opsobot/rebelia/hardware/renders/Rebelia - Open Source Robotic Hand - front.png

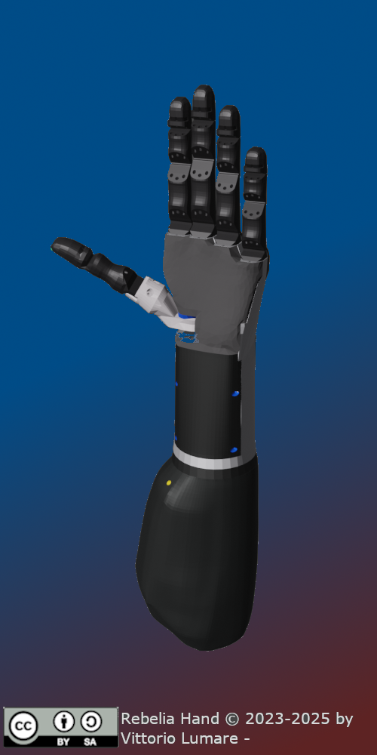
hardware/renders/Rebelia - Open Source Robotic Hand - front.png
