opsobot/rebelia/hardware/Electronics/Prosthetic Version/PdfFiles_ServoBoard Slim/MASK1.pdf

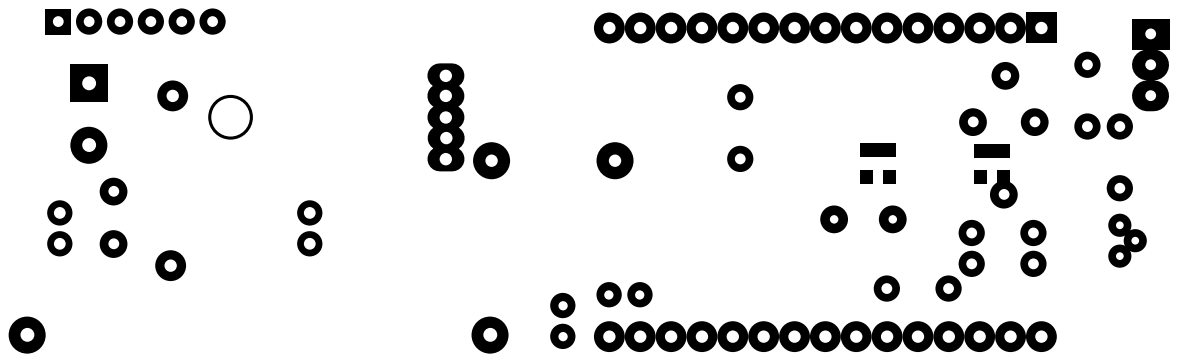
[picture p2: page 1]
