opsobot/rebelia/hardware/Electronics/Prosthetic Version/ServoBoard Slim.png

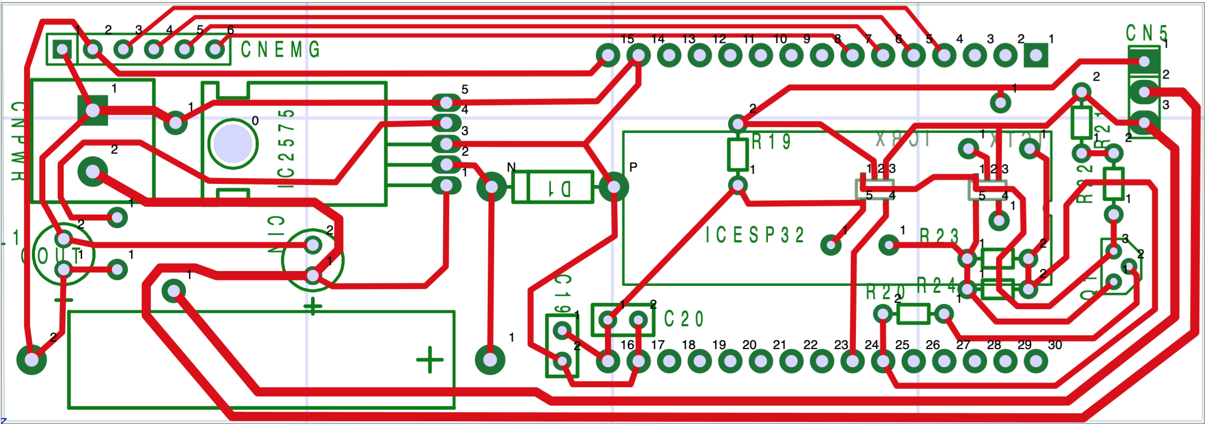
hardware/Electronics/Prosthetic Version/ServoBoard Slim.png
