opsobot/rebelia/hardware/renders/Rebelia - Open Source Robotic Hand - back.png

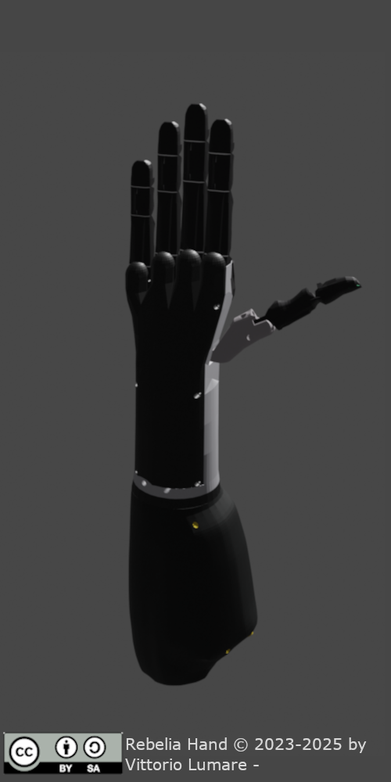
hardware/renders/Rebelia - Open Source Robotic Hand - back.png
