opsobot/rebelia/hardware/renders/Rebelia - Open Source Robotic Hand - left.png

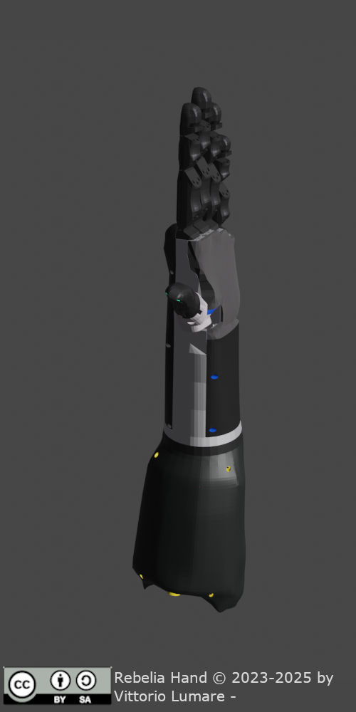
hardware/renders/Rebelia - Open Source Robotic Hand - left.png
