opsobot/rebelia/hardware/renders/Rebelia - Open Source Robotic Hand - right.png

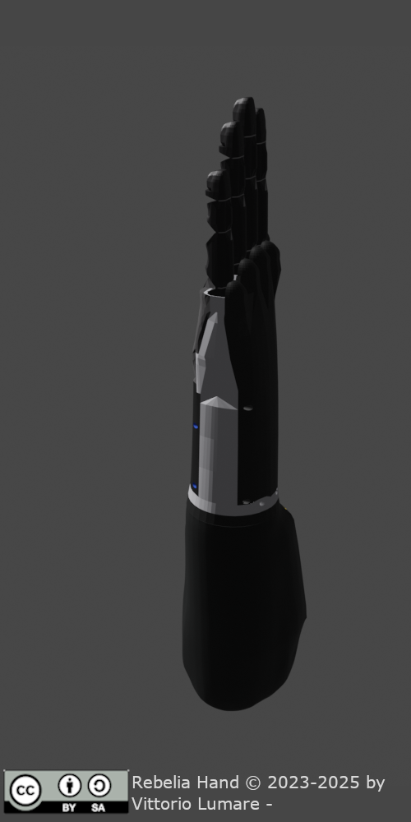
hardware/renders/Rebelia - Open Source Robotic Hand - right.png
