opsobot/rebelia/hardware/Electronics/Prosthetic Version/GerberFiles_ServoBoard Slim/BOM.TXT

1	1	1N4XXX		D1	
2	6	AXIAL0.2		R19	R20	R21	R22	R23	R24	
3	1	AXIAL1.50		L1	
4	1	DIP30-WIDE11		ICESP32	
5	2	DPV		ICRX	ICTX	
6	1	POWER2		CNPWR	
7	2	RAD0.1		C19	C20	
8	2	RB.1.2		CIN	COUT	
9	1	SIP3		CN5	
10	1	SIP6		CNEMG	
11	1	TO-220-5pin		IC2575	
12	1	TO-92A		Q1
