opsobot/rebelia/hardware/CAD/STL/Thumb Flex.stl

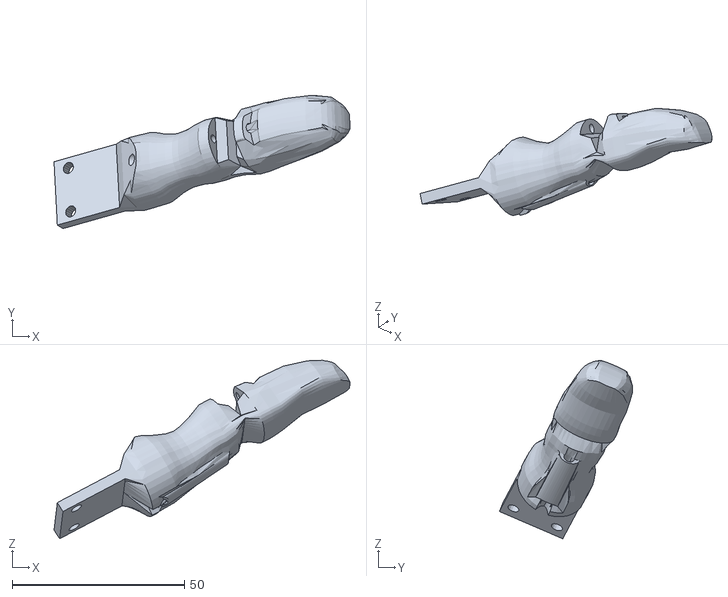
[picture p7: CAD file, 2025-03-03]
hardware/CAD/STL/Thumb Flex.stl
85.8 x 38.6 x 51.8
