opsobot/rebelia/hardware/CAD/STL/Little Flex.stl

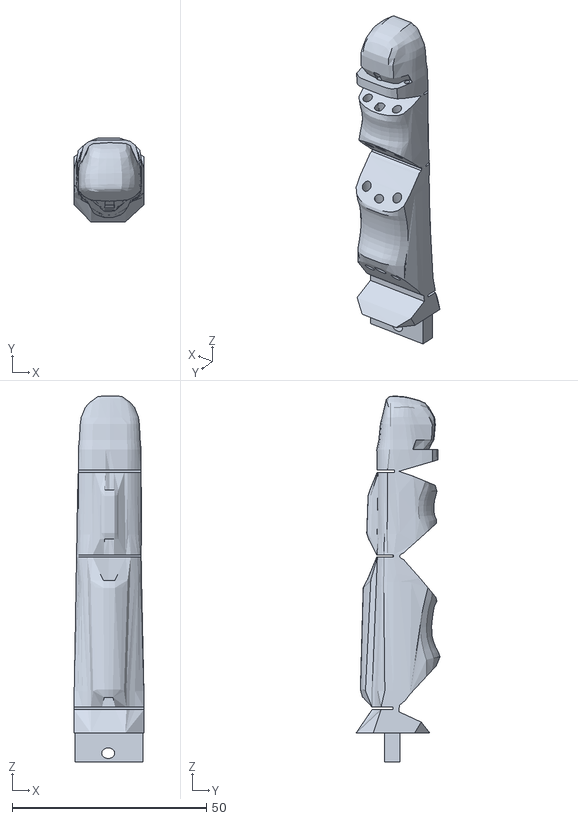
[picture p8: CAD file, 2025-03-03]
hardware/CAD/STL/Little Flex.stl
18.0 x 21.6 x 94.2
