opsobot/rebelia/hardware/CAD/STL/Middle Flex.stl

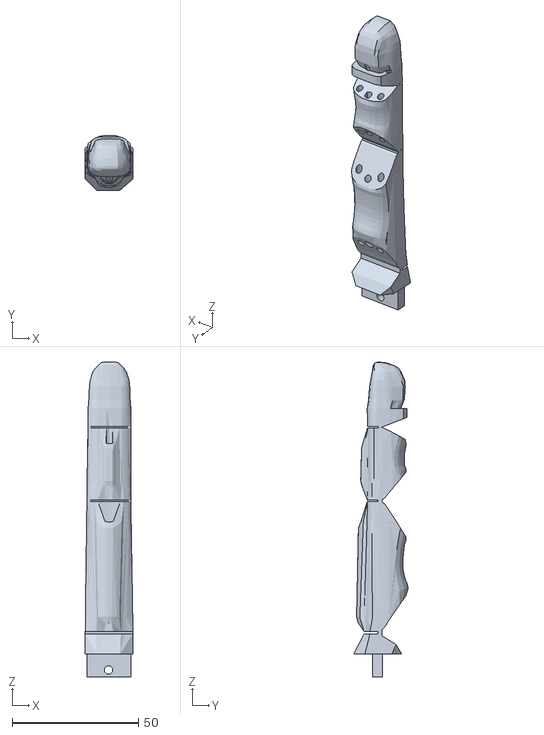
[picture p9: CAD file, 2025-03-03]
hardware/CAD/STL/Middle Flex.stl
18.9 x 21.6 x 124.8
