opsobot/rebelia/hardware/CAD/STL/Prosthetic Socket Cover - Wrist Connection.stl

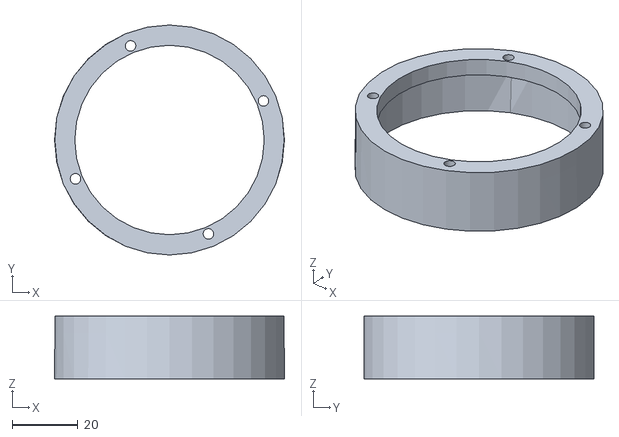
[picture p10: CAD file, 2025-03-03]
hardware/CAD/STL/Prosthetic Socket Cover - Wrist Connection.stl
70.0 x 70.0 x 19.0
