opsobot/rebelia/hardware/CAD/STL/Ring Rigid.stl

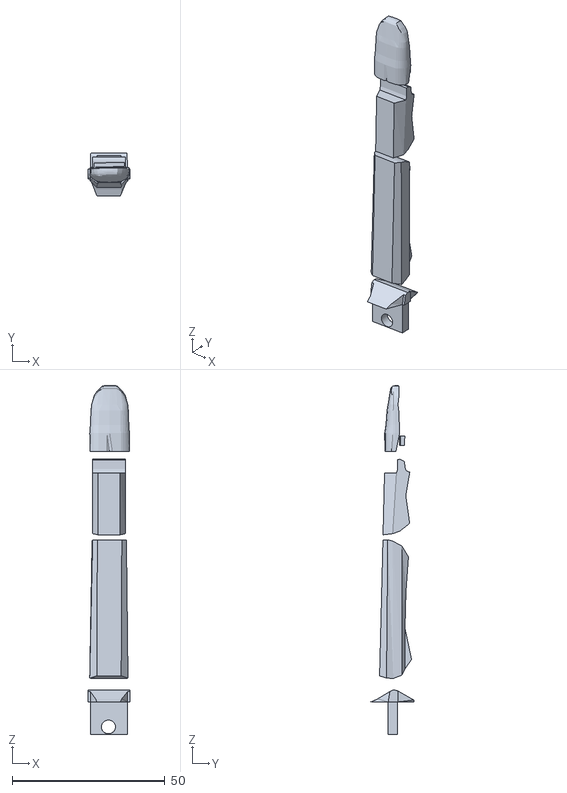
[picture p11: CAD file, 2025-03-03]
hardware/CAD/STL/Ring Rigid.stl
13.8 x 14.1 x 114.3
