opsobot/rebelia/hardware/CAD/STL/Lower Forearm Cover Front.stl

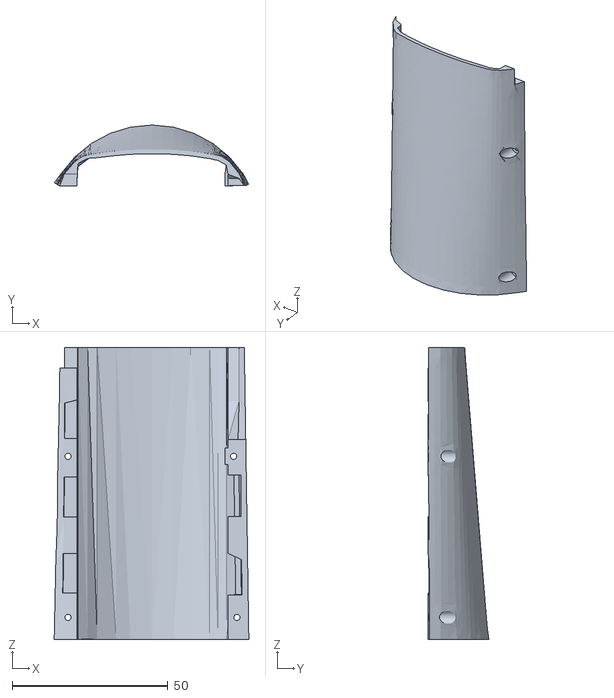
[picture p12: CAD file, 2025-03-03]
hardware/CAD/STL/Lower Forearm Cover Front.stl
62.6 x 19.6 x 93.9
