opsobot/rebelia/hardware/CAD/STL/Wrist Stop Flange.stl

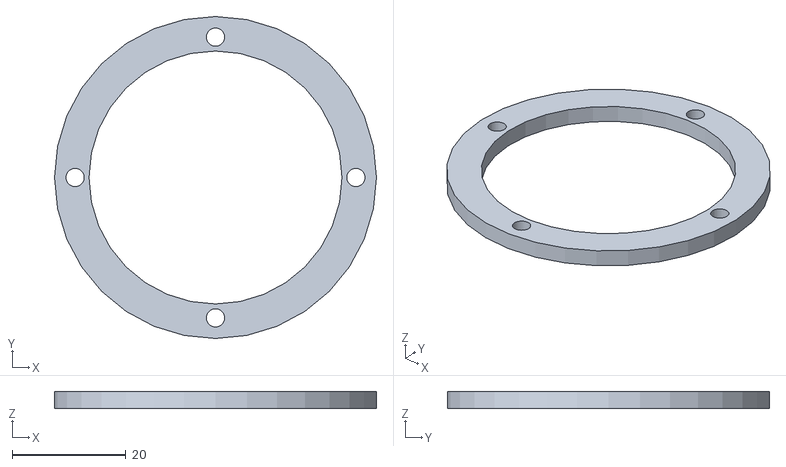
[picture p13: CAD file, 2025-03-03]
hardware/CAD/STL/Wrist Stop Flange.stl
56.5 x 56.5 x 3.00
