opsobot/rebelia/hardware/CAD/STL/Index Rigid.stl

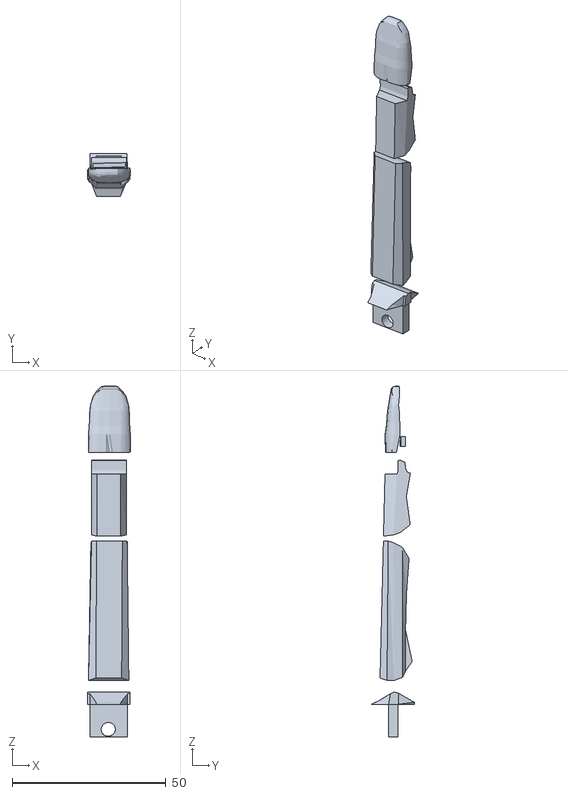
[picture p14: CAD file, 2025-03-03]
hardware/CAD/STL/Index Rigid.stl
13.9 x 14.1 x 114.3
