opsobot/rebelia/hardware/CAD/STL/Skeleton.stl

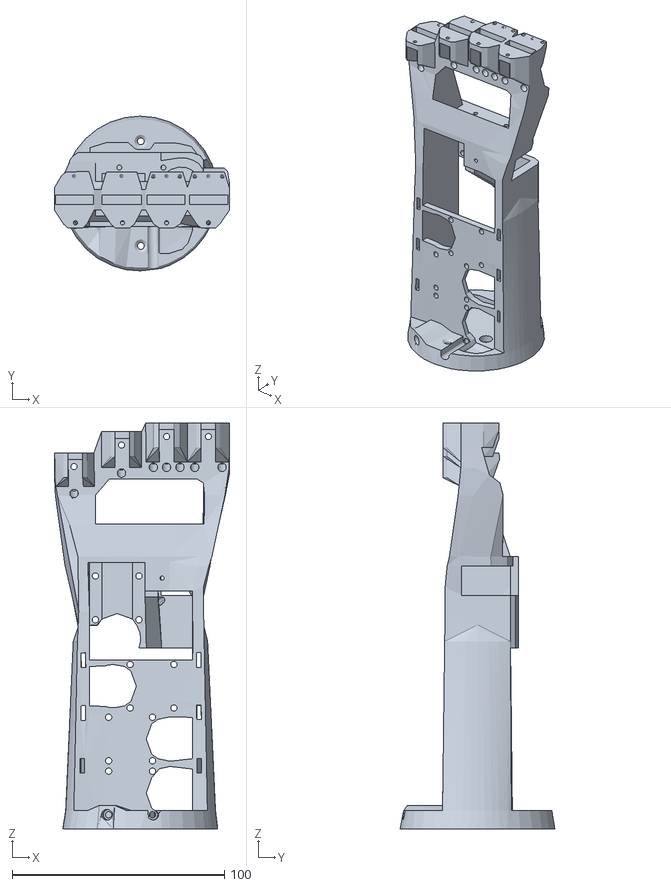
[picture p15: CAD file, 2025-03-03]
hardware/CAD/STL/Skeleton.stl
82.5 x 72.9 x 191.3
