opsobot/rebelia/hardware/CAD/STL/Middle Rigid.stl

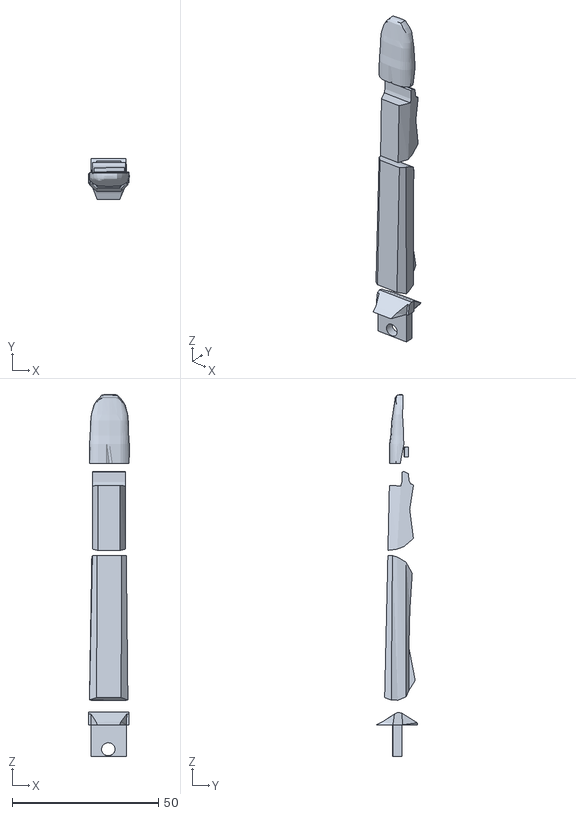
[picture p16: CAD file, 2025-03-03]
hardware/CAD/STL/Middle Rigid.stl
13.9 x 14.1 x 123.9
