opsobot/rebelia/hardware/CAD/STL/Prosthetic Socket Cover - Panel.stl

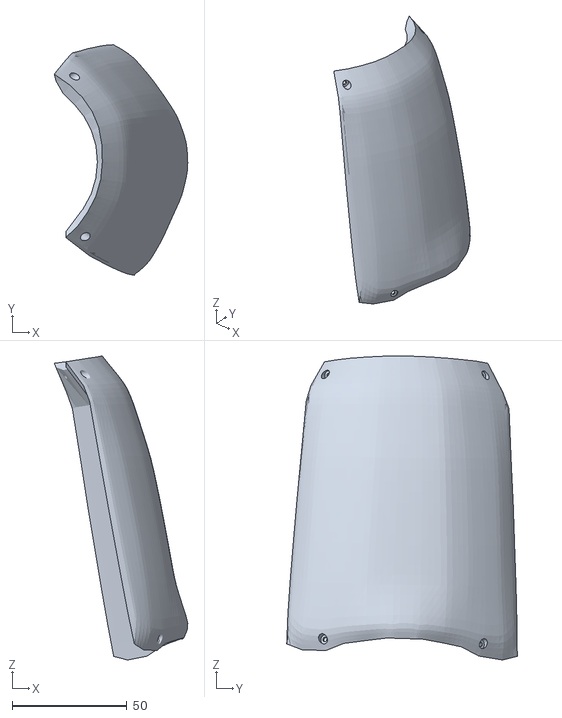
[picture p17: CAD file, 2025-03-03]
hardware/CAD/STL/Prosthetic Socket Cover - Panel.stl
58.3 x 100.7 x 132.7
