opsobot/rebelia/hardware/CAD/STL/Wrist Soft Bearings.stl

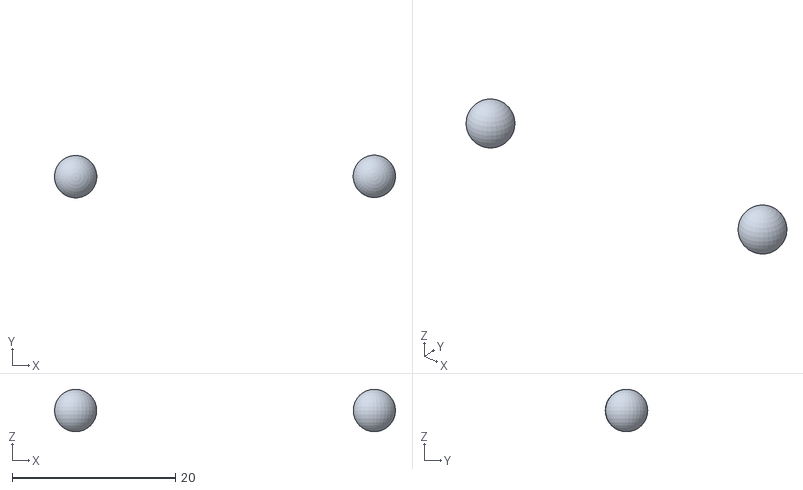
[picture p18: CAD file, 2025-03-03]
hardware/CAD/STL/Wrist Soft Bearings.stl
41.7 x 5.21 x 5.19
