opsobot/rebelia/hardware/CAD/STL/Spool.stl

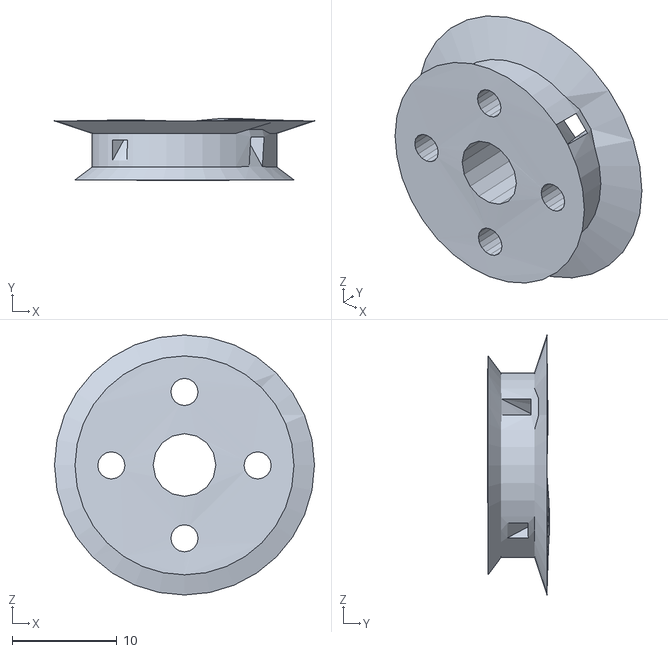
[picture p19: CAD file, 2025-03-03]
hardware/CAD/STL/Spool.stl
24.9 x 5.94 x 24.9
