opsobot/rebelia/hardware/CAD/STL/Hand Back Cover.stl

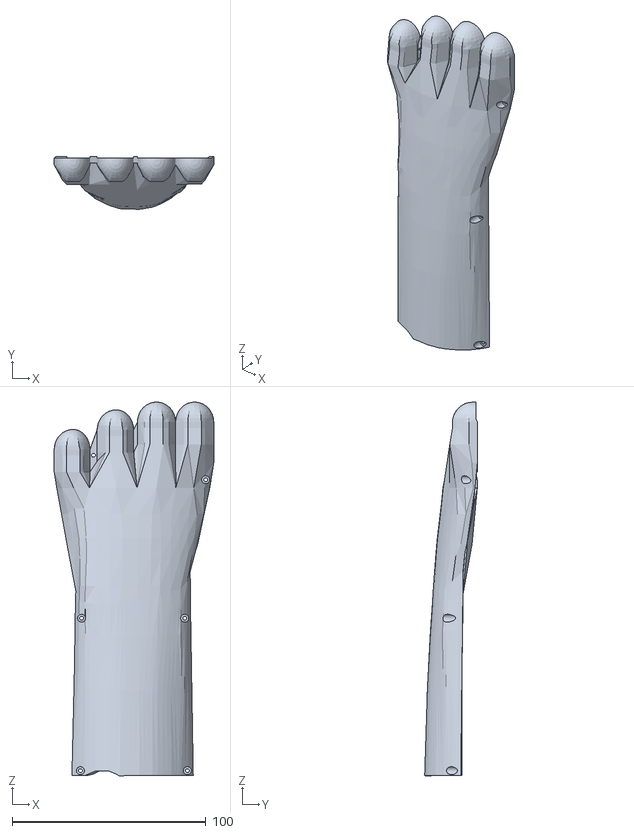
[picture p20: CAD file, 2025-03-03]
hardware/CAD/STL/Hand Back Cover.stl
82.4 x 27.2 x 193.1
