opsobot/rebelia/hardware/CAD/STL/Thumb Base.stl

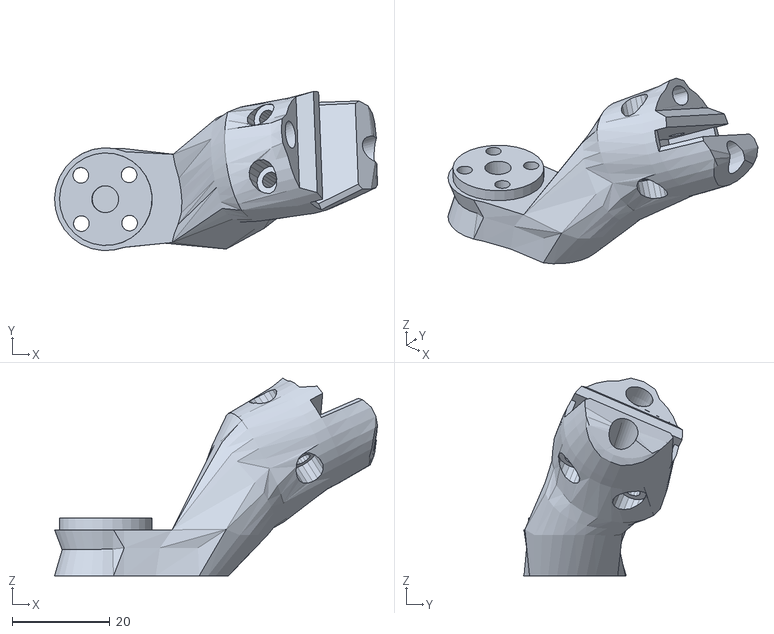
[picture p21: CAD file, 2025-03-03]
hardware/CAD/STL/Thumb Base.stl
66.2 x 32.6 x 40.5
