opsobot/rebelia/hardware/CAD/STL/Wrist Inside.stl

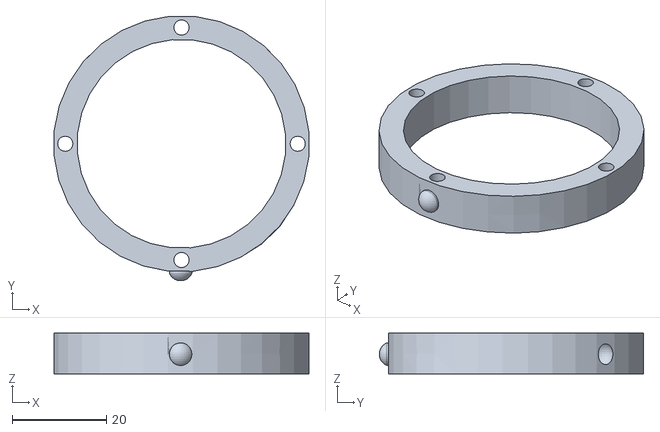
[picture p22: CAD file, 2025-03-03]
hardware/CAD/STL/Wrist Inside.stl
54.1 x 56.1 x 8.67
