opsobot/rebelia/hardware/CAD/STL/Ring Flex.stl

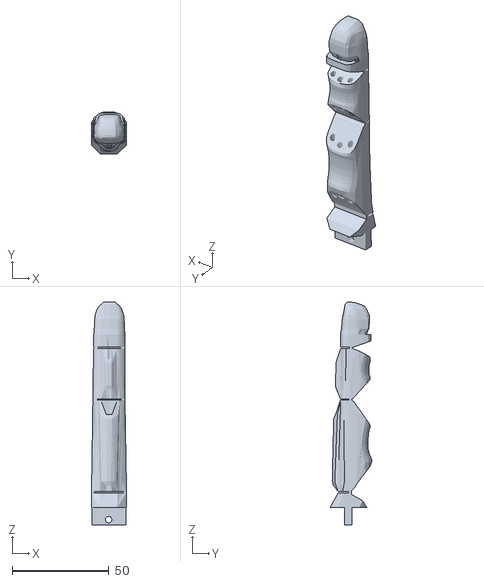
[picture p23: CAD file, 2025-03-03]
hardware/CAD/STL/Ring Flex.stl
18.0 x 21.6 x 115.2
