opsobot/rebelia/hardware/CAD/STL/Palm.stl

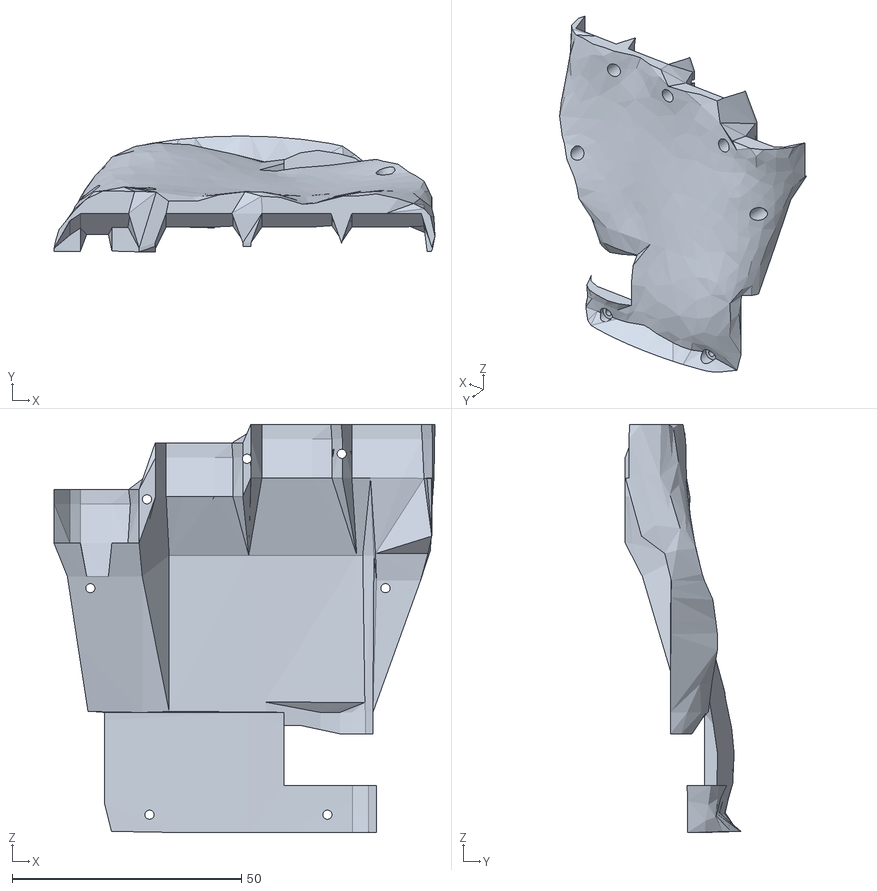
[picture p24: CAD file, 2025-03-03]
hardware/CAD/STL/Palm.stl
83.1 x 25.3 x 89.0
