opsobot/rebelia/hardware/CAD/STL/Little Rigid.stl

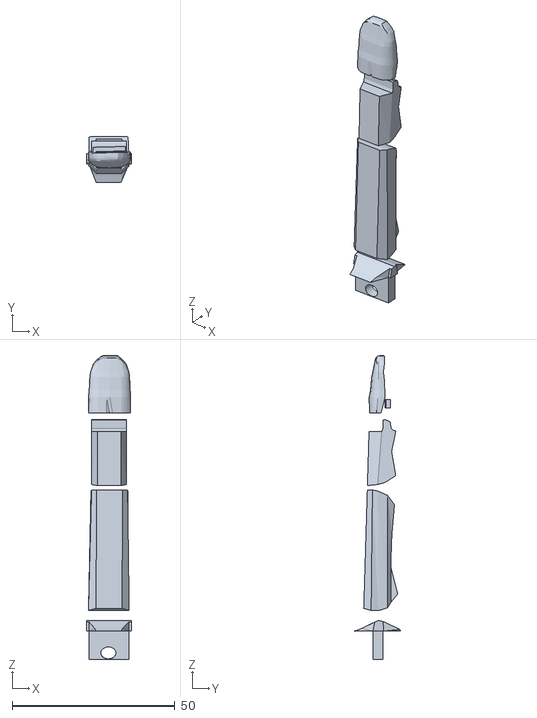
[picture p25: CAD file, 2025-03-03]
hardware/CAD/STL/Little Rigid.stl
13.8 x 14.1 x 93.5
