opsobot/rebelia/hardware/CAD/STL/Thumb Rigid.stl

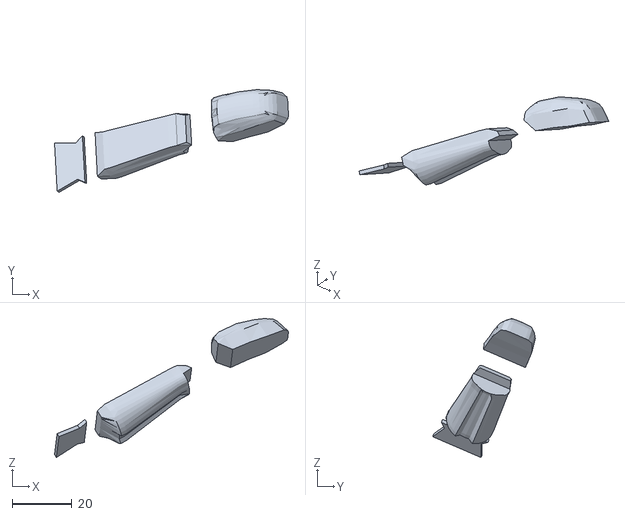
[picture p26: CAD file, 2025-03-03]
hardware/CAD/STL/Thumb Rigid.stl
78.4 x 34.5 x 46.6
