opsobot/rebelia/hardware/CAD/STL/Wrist Outside.stl

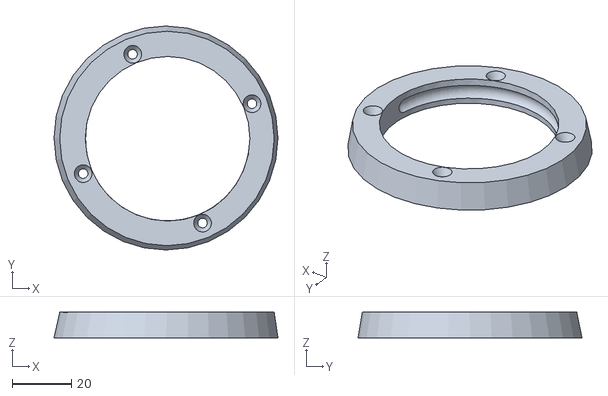
[picture p27: CAD file, 2025-03-03]
hardware/CAD/STL/Wrist Outside.stl
75.9 x 75.9 x 8.71
