opsobot/rebelia/hardware/Electronics/Prosthetic Version/PdfFiles_ServoBoard Slim/LAYER1.pdf

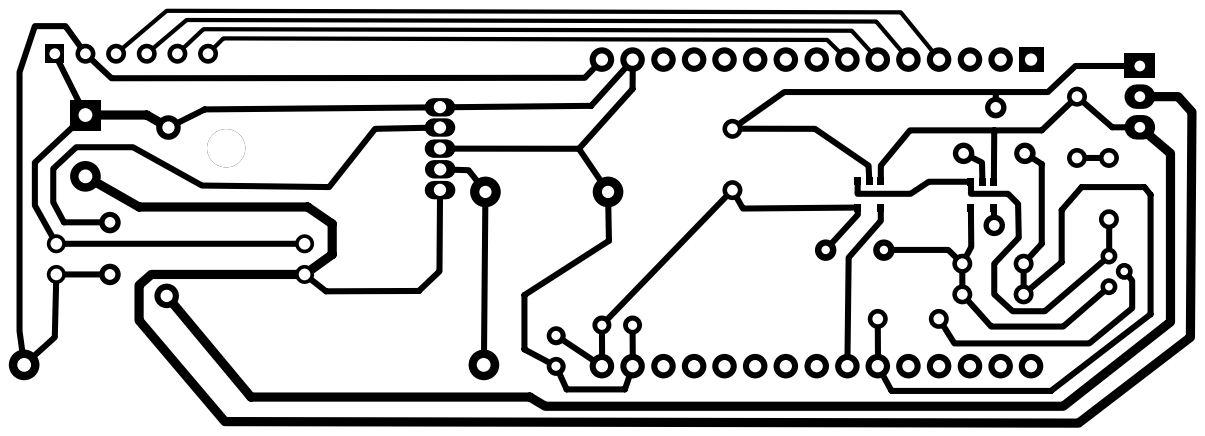
[picture p57: page 1]
