opsobot/rebelia/hardware/Electronics/Prosthetic Version/PdfFiles_ServoBoard Slim/LAYER2.pdf

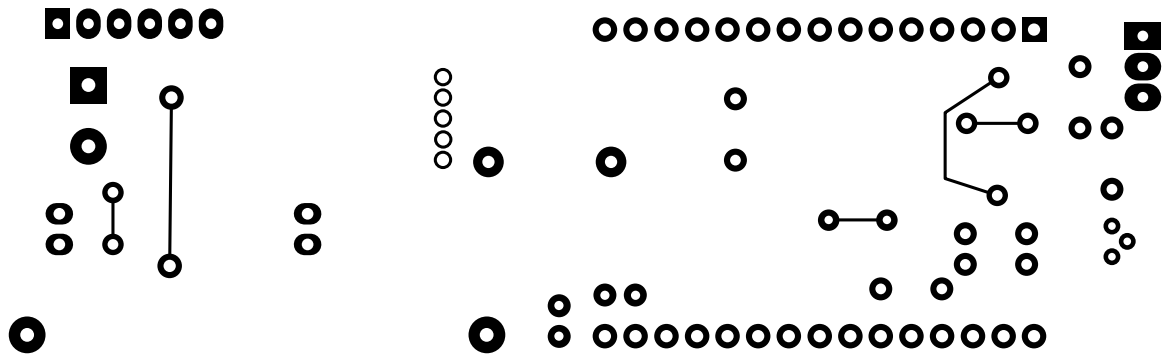
[picture p58: page 1]
