opsobot/rebelia/hardware/Electronics/Prosthetic Version/PdfFiles_ServoBoard Slim/MASK2.pdf

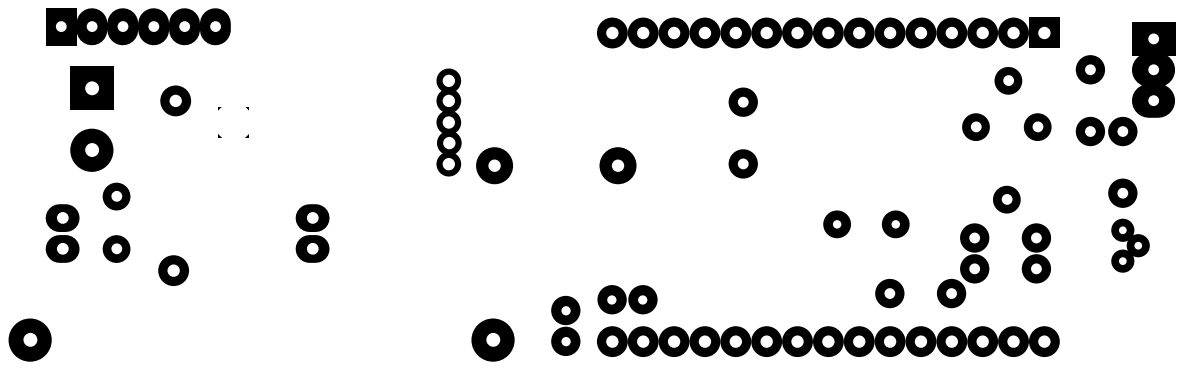
[picture p59: page 1]
