opsobot/rebelia/hardware/Electronics/Prosthetic Version/PdfFiles_ServoBoard Slim/SILK1.pdf

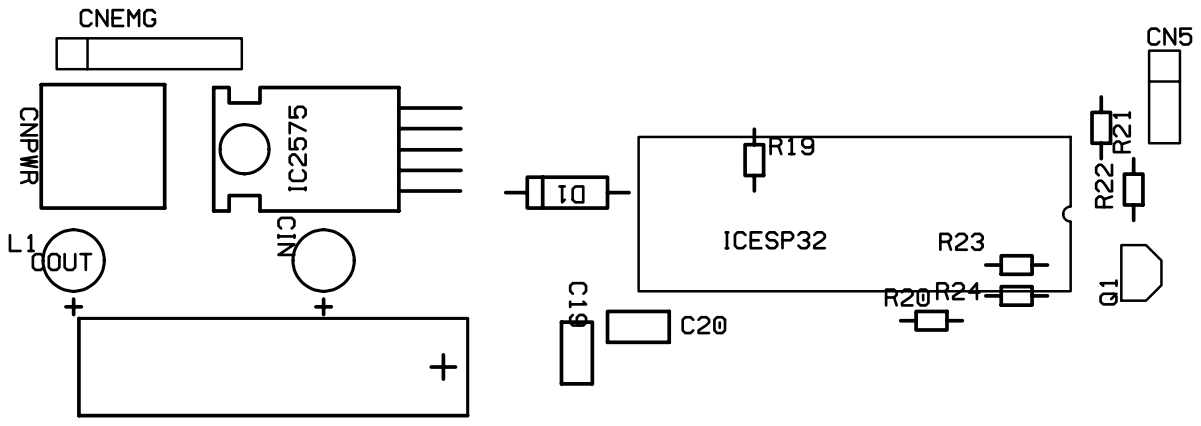
[picture p60: page 1]
