opsobot/rebelia/(commit log)

2025-03-03 Added CAD files and renders
    [Hand Back Cover.stl, Index Rigid.stl, Little Flex.stl, Little Rigid.stl, Lower Forearm Cover Front.stl, Middle Flex.stl, Middle Rigid.stl, Palm.stl]
2025-03-30 Updated license comments in the readme, moved stl files in a folder, added Blender Original Project files
    [Hand Back Cover.stl, Index Rigid.stl, Little Flex.stl, Little Rigid.stl, Lower Forearm Cover Front.stl, Middle Flex.stl, Middle Rigid.stl, Palm.stl]
2025-04-20 Update BOM.md (connectors)
2025-04-20 Update BOM.md (ESP IC model)
2025-04-20 Added Electronics Board project files
    [SPASTE1.GBR, SPASTE2.GBR, ServoBoardSlim.GBL, ServoBoardSlim.GBO, ServoBoardSlim.GBS, ServoBoardSlim.GKO, ServoBoardSlim.GTL, ServoBoardSlim.GTO]
2025-04-20 Update Readme.txt (updated readme for electronic board)
2025-04-23 Added screenshot of the prosthetic circuit board
2026-10-15 Add defensive publication, variants, trademark policy and archiving metadata
    - VARIANTS.md: alternative embodiments for prior-art purposes
    - docs/defensive-publication: technical disclosure for TDCommons
    - TRADEMARK.md: Yeah Hand trademark policy
    - CITATION.cff and .zenodo.json for citation and Zenodo archiving
    - LICENSE: fix firmware section typo, add SPDX identifiers and patent note
    - Readme: clarify license obligations, link disclosure, trademark, citation
    - Fix email typo in firmware README; ignore Arduino build output
    Claude-Session: https://claude.ai/code/session_01Ns17kwBCCYueyXaCcVxKt7
2026-10-15 Describe EMG control, fix skeleton wording, trademark covers name only
    - Technical disclosure and VARIANTS: actuators are housed in the internal
    skeleton (not forming the palm); add two-channel FFT-based EMG control,
    automatic relax, grasp selection by manual thumb positioning and EMG
    pattern grasp switching
    - Update Zenodo and citation descriptions accordingly
    - Trademark registration covers the word mark only: remove logo claims
    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
2026-10-15 Technical disclosure: use renders of the Rebelia V1 STL files
    Figures 1, 2 and 11 are now rendered from hardware/CAD/STL (published
    3 March 2025) instead of the hardware/renders images.
    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
